realrolfje/balloontv/documentation/datasheets/microcontroller-reference-sheet-1.png

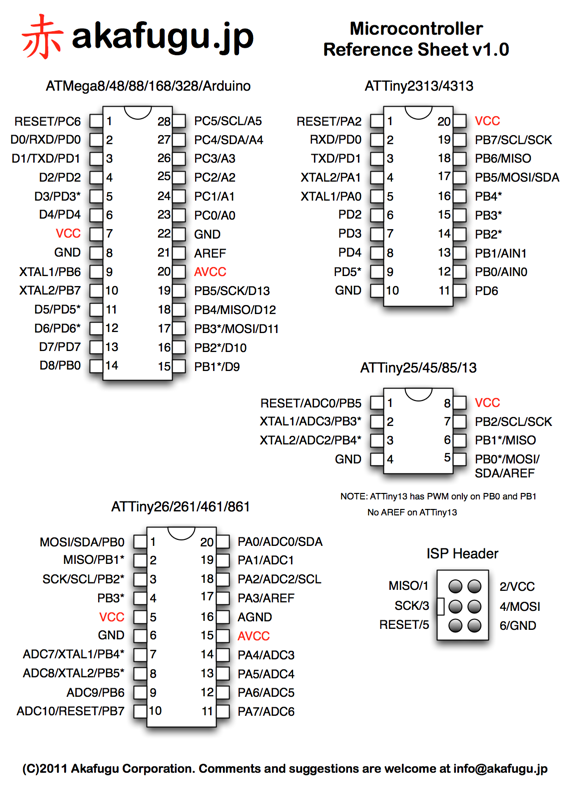
documentation/datasheets/microcontroller-reference-sheet-1.png
