realrolfje/balloontv/documentation/images/boxed-in.jpg

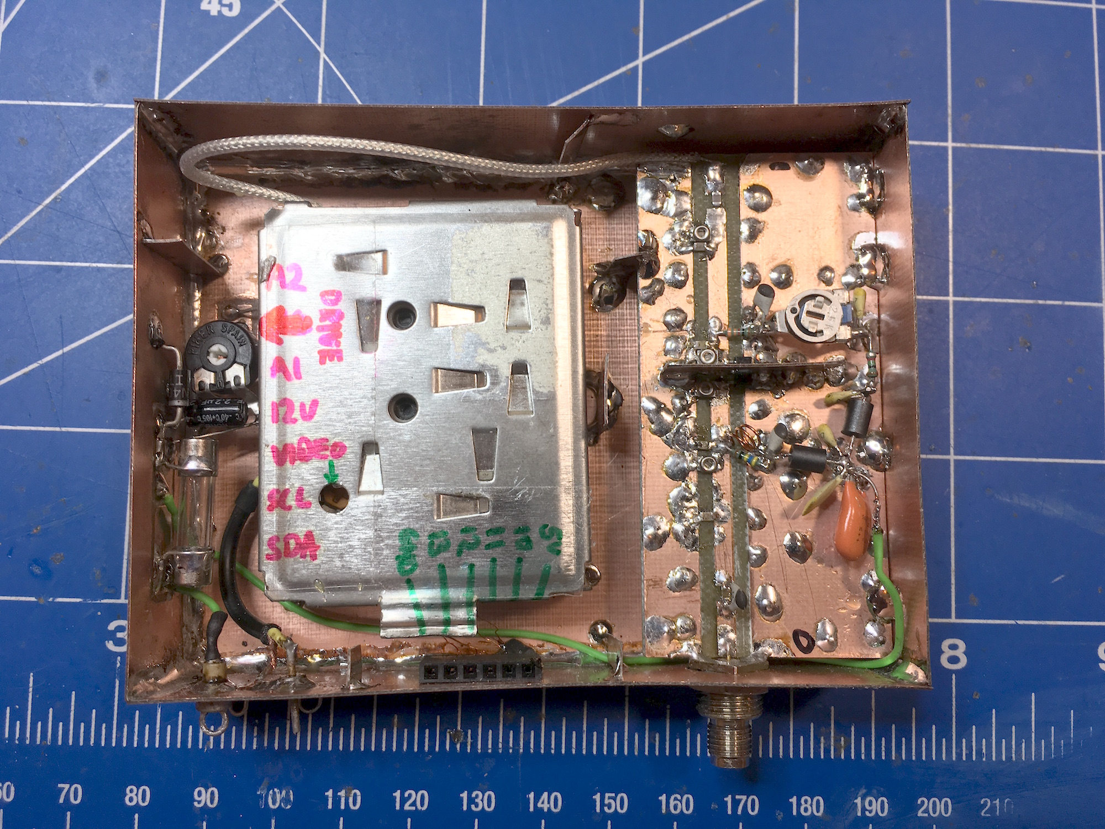
documentation/images/boxed-in.jpg
