realrolfje/balloontv/(threads)

Thread 4 (2016-08-13):

CW sending broken after move to PROGMEM

realrolfje, 2016-08-13:
The CW does not reflect the configured text. Currently it sends a lot of "T"s and some gibberish at the end. Possible causes:
- Bytes are not loaded into progmem
- Offset/index calculation is wrong

realrolfje, 2016-08-14:
Fix successfully tested, version tagged as RC1.

Closed 2016-08-14.
