realrolfje/balloontv/(commit log)

2016-07-06 I2C and Control bits documentation added
2016-07-08 I2C code enabled
2016-07-16 Tighter code, moved to ATTiny85 to be sure
    [morsekeyer.ino, setfreq.ino]
2016-07-31 Fixes, I2C tested and working!
    [setfreq.ino]
2016-08-12 cleanup, and fix for logic error introduced last commit in '.' morse symbol.
    [morsekeyer.ino]
2016-08-13 Better separation between todo and i2c image on readme.md.
2016-08-13 fixed pointer mixed in progmem read macro calls
    [morsekeyer.ino]
2016-08-14 Added link to the explanation of why it's called "Genuino". Added schematic of comtech internals.
2016-08-14 Added information about the cloverleaf antenna
2016-08-17 Added new stories to the diary. Added datasheet for the M67715 power module.
2016-08-27 Updated diary, added images. Reduced filesize of the older images to make the diary load more quickly on slower connections. Added datasheets of PD85004 and the G4BAO 23cm PA.
2017-08-12 Fixed speed and tone of CW. New version of Arduino IDE and gcc changed the way delay and/or clock speed works on the ATTiny85.
    [morsekeyer.ino, setfreq.ino]
